NeuroTinker/NeuroBytes_NID/HARDWARE/ZF-11012_PLACEMENT.pdf

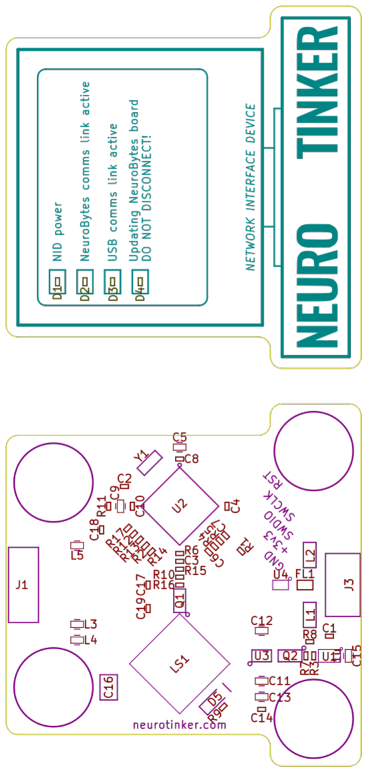
[picture p2: page 1]
