NeuroTinker/NeuroBytes_NID/HARDWARE/4-layer/mask.png

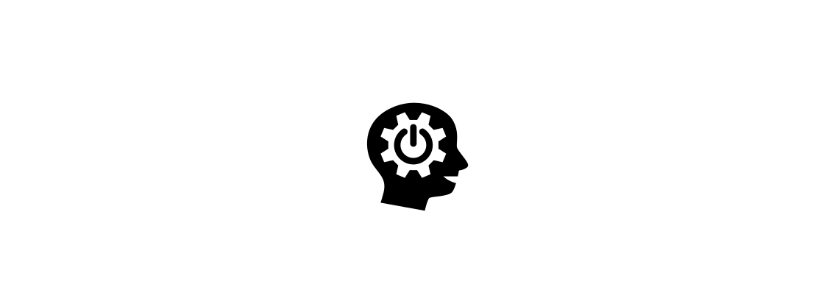
HARDWARE/4-layer/mask.png
