NeuroTinker/NeuroBytes_NID/HARDWARE/4-layer/silk.png

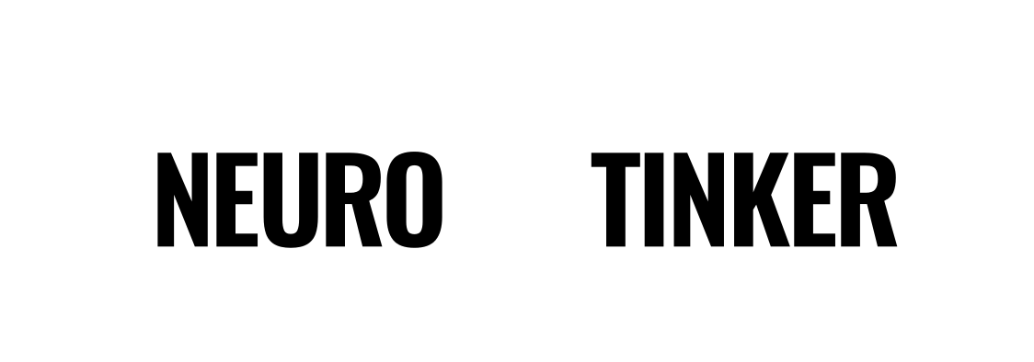
HARDWARE/4-layer/silk.png
