NeuroTinker/NeuroBytes_NID/HARDWARE/4-layer/outline.dxf

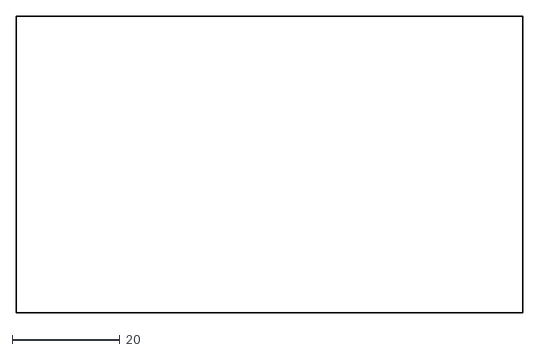
[picture p5: CAD file, 2017-11-30]
HARDWARE/4-layer/outline.dxf
94.0 x 55.0
