NeuroTinker/NeuroBytes_NID/(threads)

Thread 1 (2017-07-08):

fix reversed USB data line wiring

zakqwy, 2017-07-08:

zakqwy, 2018-03-08:
fixed several versions ago

Closed 2018-03-08.

Thread 2 (2018-03-13):

enclosed version pcb updates for next version

zakqwy, 2018-03-13:
- add cutouts for SMT female headers on main board
- switch to 1/32" FR4 for front panel
- identify and test new resonator (or find stock of current one as this p/n is EOL'd)
- increase gap on ferrite bead footprint a bit
- adjust male header spacing a bit
- try to pull traces in from mounting rails (likely not possible)
- continue to investigate alternate right angle connectors (headers are bulky)
- other tweaks as needed after checking fit with aluminum case
