NeuroTinker/NeuroBytes_NID/HARDWARE/NeuroBytes_NID_schematic.pdf

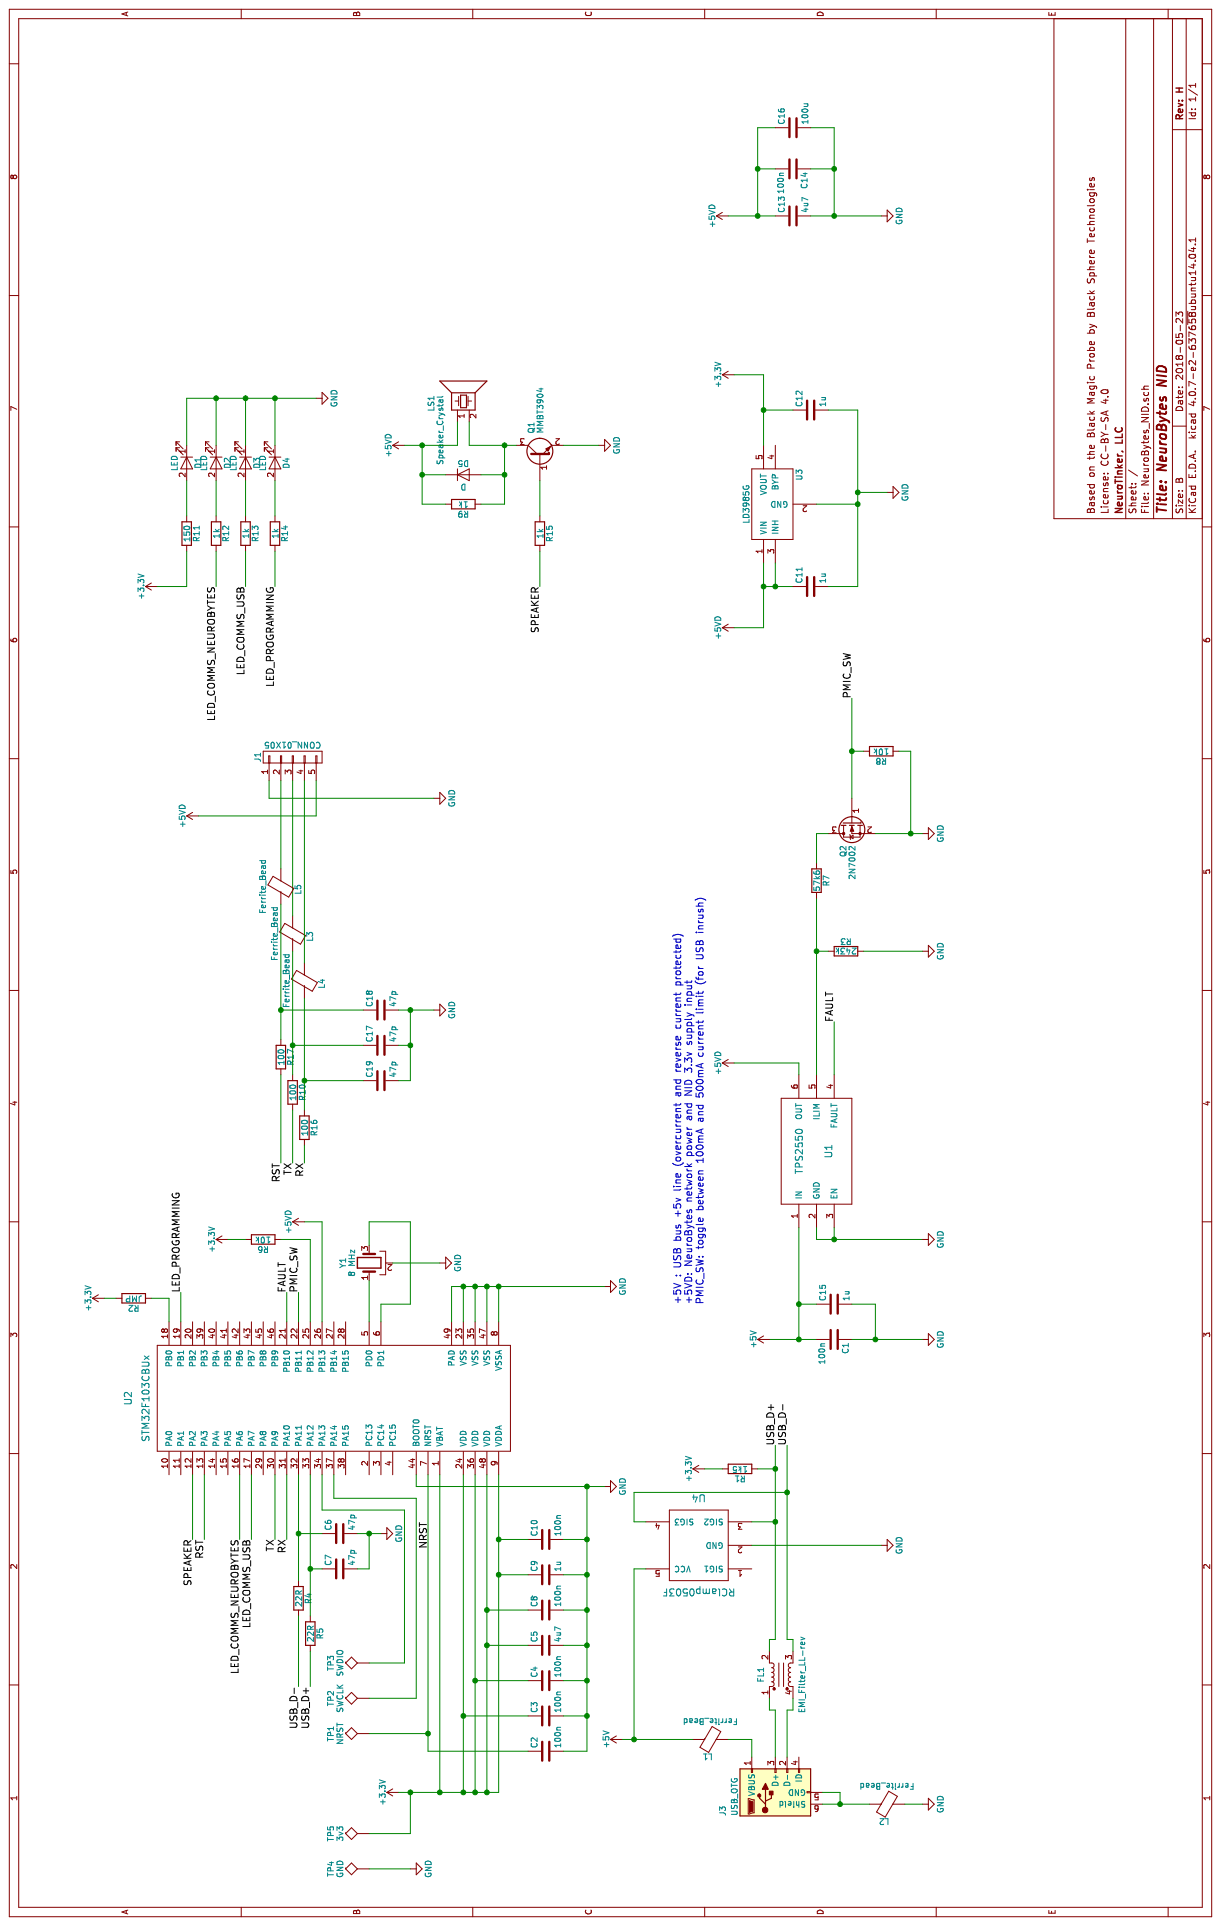
[picture p6: page 1]
