NeuroTinker/NeuroBytes_NID/HARDWARE/4-layer/NID.pdf

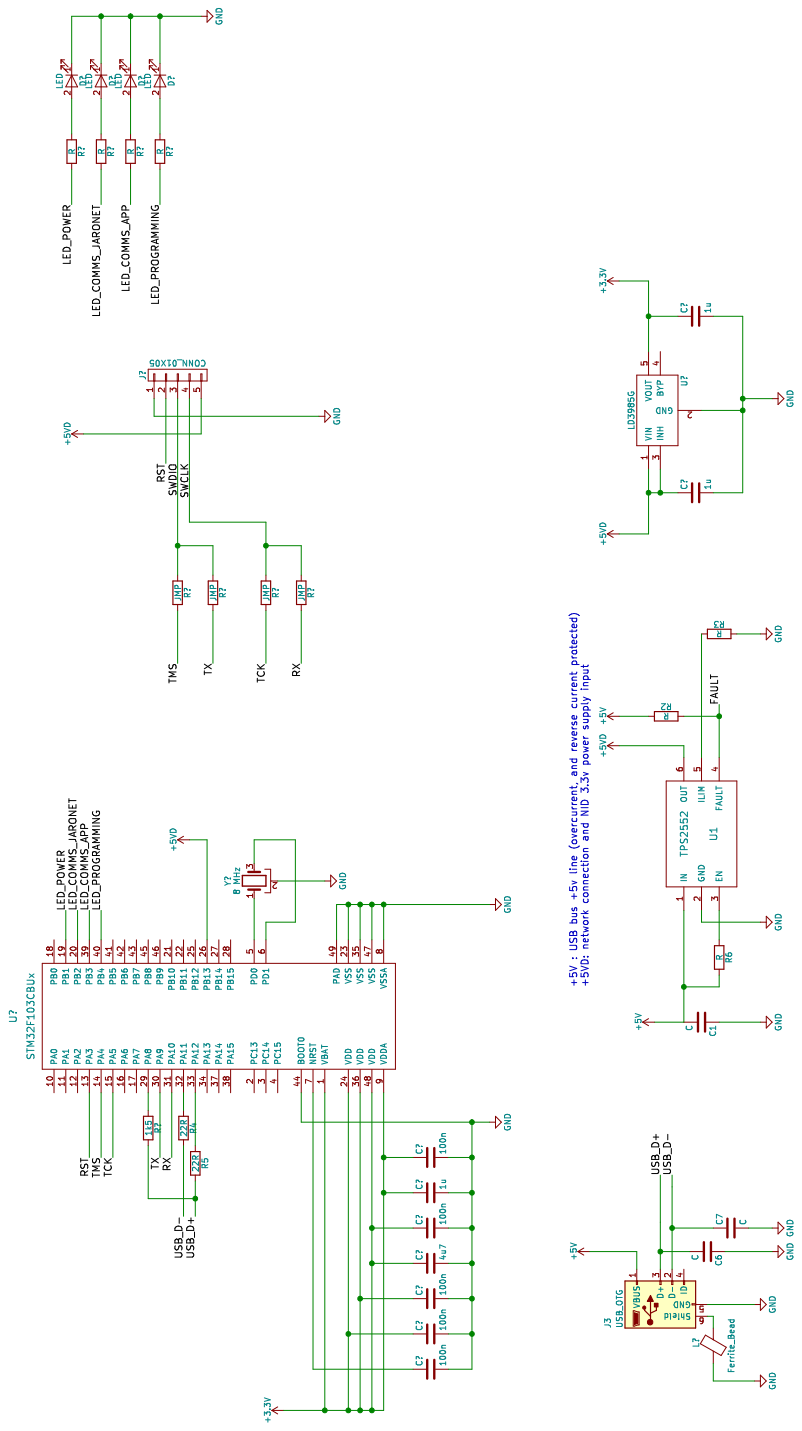
[picture p7: page 1]
