NeuroTinker/NeuroBytes_NID/FIRMWARE/src/main.c

/*
 * This file is part of the Black Magic Debug project.
 *
 * Copyright (C) 2011  Black Sphere Technologies Ltd.
 * Written by Gareth McMullin <gareth@blacksphere.co.nz>
 *
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
 * You should have received a copy of the GNU General Public License
 * along with this program.  If not, see <http://www.gnu.org/licenses/>.
 */

/* Provides main entry point.  Initialise subsystems and enter GDB
 * protocol loop.
 */

#include "general.h"
#include "gdb_if.h"
#include "gdb_main.h"
#include "target.h"
#include "exception.h"
#include "gdb_packet.h"
#include "morse.h"
#include "usbuart.h"

int
main(int argc, char **argv)
{
#if defined(LIBFTDI)
	platform_init(argc, argv);
#else
	(void) argc;
	(void) argv;
	platform_init();
#endif

	while (true) {
		volatile struct exception e;
		TRY_CATCH(e, EXCEPTION_ALL) {
			usbuart_init(); // go straight into uart mode for debug
			gdb_main();
		}
		if (e.type) {
			gdb_putpacketz("EFF");
			target_list_free();
			morse("TARGET LOST.", 1);
		}
	}

	/* Should never get here */
	return 0;
}
