NeuroTinker/NeuroBytes_NID/FIRMWARE/src/command.c

/*
 * This file is part of the Black Magic Debug project.
 *
 * Copyright (C) 2011  Black Sphere Technologies Ltd.
 * Written by Gareth McMullin <gareth@blacksphere.co.nz>
 *
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
 * You should have received a copy of the GNU General Public License
 * along with this program.  If not, see <http://www.gnu.org/licenses/>.
 */

/* This file implements a basic command interpreter for GDB 'monitor'
 * commands.
 */

#include "general.h"
#include "exception.h"
#include "command.h"
#include "gdb_packet.h"
#include "target.h"
#include "morse.h"
#include "version.h"
#include "usbuart.h"

#ifdef PLATFORM_HAS_TRACESWO
#	include "traceswo.h"
#endif

typedef bool (*cmd_handler)(target *t, int argc, const char **argv);

struct command_s {
	const char *cmd;
	cmd_handler handler;

	const char *help;
};

static bool cmd_version(void);
static bool cmd_enter_dfu(void);
static bool cmd_enter_swd(void);
static bool cmd_enter_uart(void);
static bool cmd_prog_led(void);
static bool cmd_uart_led(void);
static bool cmd_usb_led(void);
static bool cmd_help(target *t);

static bool cmd_jtag_scan(target *t, int argc, char **argv);
static bool cmd_swdp_scan(void);
static bool cmd_targets(void);
static bool cmd_morse(void);
static bool cmd_connect_srst(target *t, int argc, const char **argv);
static bool cmd_hard_srst(void);
#ifdef PLATFORM_HAS_POWER_SWITCH
static bool cmd_target_power(target *t, int argc, const char **argv);
#endif
#ifdef PLATFORM_HAS_TRACESWO
static bool cmd_traceswo(void);
#endif
#ifdef PLATFORM_HAS_DEBUG
static bool cmd_debug_bmp(target *t, int argc, const char **argv);
#endif

const struct command_s cmd_list[] = {
	{"version", (cmd_handler)cmd_version, "Display firmware version info"},
	{"help", (cmd_handler)cmd_help, "Display help for monitor commands"},
	{"jtag_scan", (cmd_handler)cmd_jtag_scan, "Scan JTAG chain for devices" },
	{"swdp_scan", (cmd_handler)cmd_swdp_scan, "Scan SW-DP for devices" },
	{"targets", (cmd_handler)cmd_targets, "Display list of available targets" },
	{"morse", (cmd_handler)cmd_morse, "Display morse error message" },
	{"connect_srst", (cmd_handler)cmd_connect_srst, "Configure connect under SRST: (enable|disable)" },
	{"hard_srst", (cmd_handler)cmd_hard_srst, "Force a pulse on the hard SRST line - disconnects target" },
	{"enter_dfu", (cmd_handler)cmd_enter_dfu, "Enter DFU mode"},
	{"enter_swd", (cmd_handler)cmd_enter_swd, "Enter SWD mode"},
	{"enter_uart", (cmd_handler)cmd_enter_uart, "Enter UART mode"},
	{"prog_led", (cmd_handler)cmd_prog_led, "Toggle programming LED"},
	{"uart_led", (cmd_handler)cmd_uart_led, "Toggle uart LED"},
	{"usb_led", (cmd_handler)cmd_usb_led, "Toggle usb LED"},
#ifdef PLATFORM_HAS_POWER_SWITCH
	{"tpwr", (cmd_handler)cmd_target_power, "Supplies power to the target: (enable|disable)"},
#endif
#ifdef PLATFORM_HAS_TRACESWO
	{"traceswo", (cmd_handler)cmd_traceswo, "Start trace capture" },
#endif
#ifdef PLATFORM_HAS_DEBUG
	{"debug_bmp", (cmd_handler)cmd_debug_bmp, "Output BMP \"debug\" strings to the second vcom: (enable|disable)"},
#endif
	{NULL, NULL, NULL}
};

static bool connect_assert_srst;
#ifdef PLATFORM_HAS_DEBUG
bool debug_bmp;
#endif

int command_process(target *t, char *cmd)
{
	const struct command_s *c;
	int argc = 0;
	const char **argv;

	/* Initial estimate for argc */
	for(char *s = cmd; *s; s++)
		if((*s == ' ') || (*s == '\t')) argc++;

	argv = alloca(sizeof(const char *) * argc);

	/* Tokenize cmd to find argv */
	for(argc = 0, argv[argc] = strtok(cmd, " \t");
		argv[argc]; argv[++argc] = strtok(NULL, " \t"));

	/* Look for match and call handler */
	for(c = cmd_list; c->cmd; c++) {
		/* Accept a partial match as GDB does.
		 * So 'mon ver' will match 'monitor version'
		 */
		if ((argc == 0) || !strncmp(argv[0], c->cmd, strlen(argv[0])))
			return !c->handler(t, argc, argv);
	}

	if (!t)
		return -1;

	return target_command(t, argc, argv);
}

bool cmd_enter_swd(void)
{
	usbuart_deinit();
	gpio_set_mode(SWDIO_PORT, GPIO_MODE_OUTPUT_50_MHZ,
		GPIO_CNF_OUTPUT_PUSHPULL,
		SWDIO_PIN | SWCLK_PIN);
	return false;
}

bool cmd_enter_uart(void)
{
	usbuart_init();
	return false;
}

bool cmd_enter_dfu(void)
{
	pwr_disable_backup_domain_write_protect();
	
	BKP_DR5 |= 0b1; // write a bit to bkp register for restarting in dfu mode
	scb_reset_system();
	return false;
}

bool cmd_prog_led(void)
{
	gpio_toggle(PORT_LED_PROG, PIN_LED_PROG);
	return false;
}

bool cmd_uart_led(void)
{
	gpio_toggle(PORT_LED_COMMS, PIN_LED_COMMS);
	return false;
}

bool cmd_usb_led(void)
{
	gpio_toggle(PORT_LED_USB, PIN_LED_USB);
	return false;
}

bool cmd_version(void)
{
	gdb_outf("Black Magic Probe (Firmware " FIRMWARE_VERSION ") (Hardware Version %d)\n", platform_hwversion());
	gdb_out("Copyright (C) 2015  Black Sphere Technologies Ltd.\n");
	gdb_out("License GPLv3+: GNU GPL version 3 or later "
		"<http://gnu.org/licenses/gpl.html>\n\n");

	return true;
}

bool cmd_help(target *t)
{
	const struct command_s *c;

	gdb_out("General commands:\n");
	for(c = cmd_list; c->cmd; c++)
		gdb_outf("\t%s -- %s\n", c->cmd, c->help);

	if (!t)
		return -1;

	target_command_help(t);

	return true;
}

static bool cmd_jtag_scan(target *t, int argc, char **argv)
{
	(void)t;
	uint8_t irlens[argc];

	gdb_outf("Target voltage: %s\n", platform_target_voltage());

	if (argc > 1) {
		/* Accept a list of IR lengths on command line */
		for (int i = 1; i < argc; i++)
			irlens[i-1] = atoi(argv[i]);
		irlens[argc-1] = 0;
	}

	if(connect_assert_srst)
		platform_srst_set_val(true); /* will be deasserted after attach */

	int devs = -1;
	volatile struct exception e;
	TRY_CATCH (e, EXCEPTION_ALL) {
		devs = jtag_scan(argc > 1 ? irlens : NULL);
	}
	switch (e.type) {
	case EXCEPTION_TIMEOUT:
		gdb_outf("Timeout during scan. Is target stuck in WFI?\n");
		break;
	case EXCEPTION_ERROR:
		gdb_outf("Exception: %s\n", e.msg);
		break;
	}

	if(devs <= 0) {
		platform_srst_set_val(false);
		gdb_out("JTAG device scan failed!\n");
		return false;
	}
	cmd_targets();
	morse(NULL, false);
	return true;
}

bool cmd_swdp_scan(void)
{
	gdb_outf("Target voltage: %s\n", platform_target_voltage());

	if(connect_assert_srst)
		platform_srst_set_val(true); /* will be deasserted after attach */

	int devs = -1;
	volatile struct exception e;
	TRY_CATCH (e, EXCEPTION_ALL) {
		devs = adiv5_swdp_scan();
	}
	switch (e.type) {
	case EXCEPTION_TIMEOUT:
		gdb_outf("Timeout during scan. Is target stuck in WFI?\n");
		break;
	case EXCEPTION_ERROR:
		gdb_outf("Exception: %s\n", e.msg);
		break;
	}

	if(devs <= 0) {
		platform_srst_set_val(false);
		gdb_out("SW-DP scan failed!\n");
		return false;
	}

	cmd_targets();
	morse(NULL, false);
	return true;

}

static void display_target(int i, target *t, void *context)
{
	(void)context;
	gdb_outf("%2d   %c  %s\n", i, target_attached(t)?'*':' ', target_driver_name(t));
}

bool cmd_targets(void)
{
	gdb_out("Available Targets:\n");
	gdb_out("No. Att Driver\n");
	if (!target_foreach(display_target, NULL)) {
		gdb_out("No usable targets found.\n");
		return false;
	}

	return true;
}

bool cmd_morse(void)
{
	if(morse_msg)
		gdb_outf("%s\n", morse_msg);
	return true;
}

static bool cmd_connect_srst(target *t, int argc, const char **argv)
{
	(void)t;
	if (argc == 1)
		gdb_outf("Assert SRST during connect: %s\n",
			 connect_assert_srst ? "enabled" : "disabled");
	else
		connect_assert_srst = !strcmp(argv[1], "enable");
	return true;
}

static bool cmd_hard_srst(void)
{
	target_list_free();
	platform_srst_set_val(true);
	platform_srst_set_val(false);
	return true;
}

#ifdef PLATFORM_HAS_POWER_SWITCH
static bool cmd_target_power(target *t, int argc, const char **argv)
{
	(void)t;
	if (argc == 1)
		gdb_outf("Target Power: %s\n",
			 platform_target_get_power() ? "enabled" : "disabled");
	else
		platform_target_set_power(!strncmp(argv[1], "enable", strlen(argv[1])));
	return true;
}
#endif

#ifdef PLATFORM_HAS_TRACESWO
static bool cmd_traceswo(void)
{
	extern char serial_no[9];
	traceswo_init();
	gdb_outf("%s:%02X:%02X\n", serial_no, 5, 0x85);
	return true;
}
#endif

#ifdef PLATFORM_HAS_DEBUG
static bool cmd_debug_bmp(target *t, int argc, const char **argv)
{
	(void)t;
	if (argc > 1) {
		debug_bmp = !strcmp(argv[1], "enable");
	}
	gdb_outf("Debug mode is %s\n",
		 debug_bmp ? "enabled" : "disabled");
	return true;
}
#endif
