NeuroTinker/NeuroBytes_NID/(commit log)

2017-05-17 Initial commit. Started putting schematic bits together: Teensy v3.2 w/ bootloader chip, 50-pin LCD connector, STM32L0, various connectors. Grabbed NeuroTinker schematic and libopencm3 submodules.
    [NeuroBytes_NID.sch]
2017-05-18 Finished schematic (for now) and footprints. Started routing PCB.
    [NeuroBytes_NID.kicad_pcb, NeuroBytes_NID.sch]
2017-06-17 added usb board
    [Serial_NID.dsn, Serial_NID.kicad_pcb, Serial_NID.sch, USB_serial.sch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]
2017-06-19 updated pcb
    [Serial_NID.kicad_pcb, Serial_NID.sch, _saved_Serial_NID.sch]
2017-06-19 updated TX RX
    [Serial_NID.kicad_pcb]
2017-06-19 fixed pcb
    [Serial_NID.kicad_pcb, Serial_NID.sch, _saved_Serial_NID.sch]
2017-06-19 fixd pcb
    [Serial_NID.kicad_pcb]
2017-10-25 deleted old project files. put together schematic for NID based on BMP + PMIC. no PCB layout or design yet.
    [NeuroBytes_NID.kicad_pcb, NeuroBytes_NID.sch, Serial_NID.dsn, Serial_NID.kicad_pcb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]
2017-11-01 finalized NID schematic and PCB layout
    [NeuroBytes_NID.sch]
2017-11-30 updated license, readme, and PCB
    [NeuroBytes_NID.kicad_pcb, outline.dxf]
2017-12-19 updated PCB print to include fab info
    [NeuroBytes_NID.kicad_pcb]
2017-12-22 hardware rev C. fixed USB stuff, moved LED, updated PMIC, etc
    [NeuroBytes_NID.kicad_pcb, NeuroBytes_NID.sch]
2018-01-31 add'l ESD/EMC mitigation measures
    [NeuroBytes_NID.kicad_pcb, NeuroBytes_NID.sch]
2018-01-31 added resistor across piezo element after breadboard test to increase volume
    [NeuroBytes_NID.kicad_pcb, NeuroBytes_NID.sch]
2018-01-31 updated PCB rev notes. grounded JST structural pads. ordered PCBs.
    [NeuroBytes_NID.kicad_pcb, NeuroBytes_NID.sch]
2018-02-01 added bulk cap on 5VD line. added more test points. ordered 3 PCBs.
    [NeuroBytes_NID.kicad_pcb, NeuroBytes_NID.sch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]
2018-02-28 rework board updates
2018-03-06 more EMC-related changes. added version with enclosure.
    [NeuroBytes_NID.kicad_pcb, NeuroBytes_NID.sch, NeuroBytes_NID_Enclosed.kicad_pcb, NeuroBytes_NID_Enclosed.sch, outline.dxf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]
2018-03-08 created PCB render. updated README.md
    [NeuroBytes_NID_Enclosed-F.Paste.gbr]
2018-03-12 assembled and tested board; fixed reversed traces on front panel. front-only files only include this board so they can be ordered alone.
    [NeuroBytes_NID_Enclosed.kicad_pcb, NeuroBytes_NID_Enclosed.sch, NeuroBytes_NID_Enclosed_front-only.kicad_pcb]
2018-04-08 turned off adc
2018-04-08 added filtering to NeuroBytes network connection. updated USB ferrites and resonator footprints.
    [NeuroBytes_NID.kicad_pcb, NeuroBytes_NID.sch, NeuroBytes_NID_Enclosed.sch, NeuroBytes_NID_Enclosed_base-only.kicad_pcb]
2018-04-09 added 4-layer design
    [NeuroBytes_NID-B.Paste_4-layer.gbr, NeuroBytes_NID_4-layer-B.Cu.gbr, NeuroBytes_NID_4-layer-B.Mask.gbr, NeuroBytes_NID_4-layer-B.Paste.gbr, NeuroBytes_NID_4-layer-B.SilkS.gbr, NeuroBytes_NID_4-layer-Edge.Cuts.gbr, NeuroBytes_NID_4-layer-F.Cu.gbr, NeuroBytes_NID_4-layer-F.Mask.gbr]
2018-05-23 updates to 4-layer and enclosed NID versions
    [NeuroBytes_NID_4-layer-B.Cu.gbr, NeuroBytes_NID_4-layer-B.Mask.gbr, NeuroBytes_NID_4-layer-B.Paste.gbr, NeuroBytes_NID_4-layer-B.SilkS.gbr, NeuroBytes_NID_4-layer-Edge.Cuts.gbr, NeuroBytes_NID_4-layer-F.Cu.gbr, NeuroBytes_NID_4-layer-F.Mask.gbr, NeuroBytes_NID_4-layer-F.Paste.gbr]
2018-05-23 added BOM info and generated BOM. generated fab files.
    [NeuroBytes_NID-B.Cu.gbr, NeuroBytes_NID-B.Mask.gbr, NeuroBytes_NID-B.Paste.gbr, NeuroBytes_NID-B.SilkS.gbr, NeuroBytes_NID-Edge.Cuts.gbr, NeuroBytes_NID-F.Cu.gbr, NeuroBytes_NID-F.Fab.gbr, NeuroBytes_NID-F.Mask.gbr]
2018-05-31 added schematic *.pdf export
2018-08-08 updated footprints to include B.Fab outlines. minor routing changes. re-generated Gerbers. added placement pdf.
    [NeuroBytes_NID-B.Cu.gbr, NeuroBytes_NID-B.Fab.gbr, NeuroBytes_NID-B.Mask.gbr, NeuroBytes_NID-B.Paste.gbr, NeuroBytes_NID-B.SilkS.gbr, NeuroBytes_NID-Edge.Cuts.gbr, NeuroBytes_NID-F.Cu.gbr, NeuroBytes_NID-F.Fab.gbr]
2018-08-08 regen drill file
    [NeuroBytes_NID.drl]
2018-08-30 cleaned up. added led commands
2018-10-03 fixed hwversion for srst
    [command.c, platform.c, platform.h]
