NeuroTinker/NeuroBytes_NID/(notices)

Notices in the files:
FIRMWARE/src/platforms/native/platform.h:
This program is free software: you can redistribute it and/or modify
it under the terms of the GNU General Public License as published by
the Free Software Foundation, either version 3 of the License, or
(at your option) any later version.
HARDWARE/Enclosed/NeuroBytes_NID_Enclosed_base-only.kicad_pcb:
(C) 2018 Zach Fredin
License: CC-BY-SA 4.0
README.md:
CC BY-SA 4.0
